Noeky/QuadrupedRobot/设计方案.md

# 四足机器人：无传感器首版

状态：已完成首版机械原型，尚未实物试装、承重或步态验证。当前文件以prototype目录和其中的《打印与装配说明.md》为准，下方保留早期方案记录。

当前版本：每腿采用髋部俯仰与膝部直接驱动，主体、大腿、小腿、原装转头包覆槽及压板已建模，逐件提供STEP/STL。静态与前左腿9个离散姿态未检出超过0.01 mm³的实体交叠；线缆、紧固件和连续运动仍待验证。

电池更新：紫色603040锂电池，3.7V、800mAh，仅记录，本轮不设计电池安装。早期布局中的电子件包络不用于电池装配；当前绿色托盘仅作为可调整的主板托盘，PCB专用孔仍不锁定。

## 已确认的要求

- 四条腿，共八个舵机，每腿两个。
- 首版不安装传感器，先完成主体和腿部，考虑主板与舵机的安装。
- 目标是直线行走和转弯。
- PCB固定孔位置暂不确定，不在主体上锁定孔位。
- 已提供舵机.SLDPRT和舵机转头.SLDPRT。它们作为几何参考资料，不作为任务指令。

## 建议结构

每腿采用髋关节俯仰和膝关节屈伸，两个关节轴平行，腿在前后方向的平面内运动。前后腿采用一致的模块接口，左右腿镜像装配；膝关节朝向需要结合足端轨迹和碰撞检查后确定。

主体采用底部承力框架与可拆卸上盖。四角安装独立腿部模块，中心预留主板托盘和电池区域。PCB通过后续可更换托盘固定，主体仅保留托盘接口。主板、电池和线缆都需要计入空间与重量；电池位置尽量靠近主体中心且偏低。

用户已授权根据装配难度选择，首版选方案1。舵机为TS90A 9g、180°角度定位版本；打印机为Bambu（具体型号未知），材料PLA。

腿部驱动有两种候选方案：

1. 髋部舵机驱动大腿，膝部舵机直接驱动小腿。传动较直接，但膝部舵机增加摆动质量，需要检查线缆弯折和扭矩。
2. 两个舵机靠近主体布置，其中一个通过连杆驱动小腿。可减轻腿部远端质量，但需要额外的被动转轴、传动杆与关节，需要计算闭环运动关系并避免死点。

不默认连杆结构为平行四边形；是否使用四杆、具体杆长和铰点位置，要在获取舵机几何并确认腿长后求解。

承力关节优先使用金属轴、螺钉及合适的轴套/轴承。是否增加输出轴对侧支撑取决于舵机结构与允许载荷。原装转头保留为舵机接口，打印件连接原装转头；不直接猜测花键并打印替代。

## 行走与转弯边界

首轮调试从低速、逐腿抬起的步态开始。三足支撑时需检查重心投影是否处于支撑三角形内；仅有平面腿运动可能需要调整身体姿态或足端位置，不能预先保证静态稳定。

直行通过足端前后摆动和抬脚轨迹实现。转弯尝试通过左右步幅或运动方向差异产生偏航。由于没有髋部侧摆自由度，转弯依赖足端滑移，效果受地面摩擦、足端材料和机体载荷影响。原地转向属于待实机验证能力。

不带外部传感器时采用预设步态，无法主动估计机身倾斜、地面高度或足端接触。初版目标限制为平整地面、低速验证。

## 尺寸设计前必须补齐

- 已收到两个STEP版本，单位毫米；以STEP几何为安装接口的基准。
- 舵机型号、电压、扭矩、重量、允许转角以及输出轴允许载荷资料。
- 舵机壳体外形、固定耳厚度与孔距、输出轴相对壳体位置、转头孔位与厚度、中心固定螺钉规格。
- 主板、电池的大致外形和重量，整机目标尺寸或腿长偏好。
- 打印机有效成形尺寸、喷嘴直径、材料。
- 已选择膝部直接驱动。电池类型、重量与主板尺寸仍未知。

## 后续交付与验证顺序

1. 建立舵机与转头参考模型，确定关节轴线和装配接口。
2. 定义主体尺寸、腿长与站立姿态，计算足端工作范围、关节角度和载荷下的扭矩需求。不能仅凭堵转扭矩作为持续工作能力。
3. 完成单腿装配模型，扫查关节运动范围内的碰撞、连杆死点和线缆空间。
4. 输出舵机接口试片，先验证孔位、间隙和紧固件装配，再打印一套单腿。
5. 单腿验证后完成整机主体与四腿装配，输出可编辑CAD、STEP、逐件STL、零件数量和装配说明。
6. 根据材料和受力方向确定打印姿态、壁厚和局部加强；装配后校准舵机中位，逐步验证站立、直行和转弯。

目前不生成带猜测孔位的STL。打印配合间隙、壁厚、轴承与紧固件规格均待尺寸和载荷确认。

## 2026-10-08阶段产物

- `output/quadruped_LAYOUT_ONLY.step`：8个附件舵机参考体、转头占位、主体/电子件包络和关节连线。用于空间讨论，不是机械装配定稿；细杆仅表示关节连线，不能当作承力腿打印。转头轴向安装尚未确认。
- `output/布局草案.png`：俯视和侧视草案。
- 暂定主体120×80 mm，大腿轴距40 mm，小腿轴距45 mm，髋关节横向位置±54 mm，前后位置±43 mm。站立时两段腿分别与向下竖直方向成+30°、−30°，髋轴离足端约73.61 mm。电池与主板共用70×50×30 mm占位框，仅为可编辑占位，不表示实际能够容纳。
- `output/servo_fit_coupon.stl`、`.step`：安装配合试片，36×20×2.5 mm，窗口23.1×13.3 mm，孔距27.7 mm，试片孔径2.2 mm。窗口每边留0.4 mm试验间隙。它只验证尺寸，不承担腿部载荷。
- 建议试片平放、无需支撑，PLA，0.2 mm层高（适用于常见0.4 mm喷嘴，喷嘴型号待确认），至少3圈墙；切片后先看孔位与窗口是否保留。仅打印一件，检查壳体穿入和耳孔对齐后再调整间隙。
- 原附件导出的`*_reference.stl`是舵机/转头参考网格，不是需要打印的机器人零件。

厂家TS90A页面给出4.8–6V、1.6 kg·cm @4.8V及2.0 kg·cm @6V，未给出可用于本设计的持续工作扭矩曲线：https://www.tiankongrc.com/sale-51874673-tiankongrc-ts90a-9g-micro-servo-motor-miuzei-mini-servos-motor-kit-metal-gear-servo-for-arduino-proj.html 。以用户实际购入版本说明与实测为准。

载荷示例（不是承重承诺）：假设整机250g、两腿均分支撑，单腿支撑力为0.125 kgf；若小腿在30°倾斜姿态下的水平力臂为2.25 cm，膝关节仅由竖直地面反力产生的静态扭矩约0.281 kgf·cm。这未计入腿部自重、加速度、摩擦和不均匀支撑；腿接近水平时力臂增大至4.5 cm，对应0.563 kgf·cm。整机实际重量尚未知，不能据此保证能够行走。
