Noeky/QuadrupedRobot/重新生成说明.md

# 重新生成机械原型

通常只需将prototype目录的STL导入Bambu Studio，或将逐件STEP、装配STEP导入SolidWorks查看和修改。STEP为导入实体，没有原生SolidWorks特征树。

需要修改参数重新生成时，用Python 3.12安装cad_requirements.txt中的依赖到项目的.cad_runtime目录，再运行build_prototype.py。这个环境已配置完成。

```powershell
python -m pip install --target .cad_runtime -r cad_requirements.txt
python build_prototype.py
python render_prototype.py
python check_stl.py
```

修改build_prototype.py开头的P字典可调整主体长宽、关节位置、腿长、膝轴外移、安装孔、口袋间隙等主要参数。parameters.json是生成时的记录，并非输入配置。修改后必须重新检查validations和实体连接情况；过大的尺寸变化可能导致支架断开或干涉，此时脚本的单实体检查或碰撞报告需要进一步修正结构。

render_prototype.py使用CadQuery依赖中的VTK生成预览；Windows需要正常的OpenGL驱动。预览生成失败不代表CAD实体失败。

原始舵机.STEP和舵机转头.STEP必须保留在脚本同级目录。输出包含原装舵机/转头参考体，不应打印这些参考体。
