Noeky/QuadrupedRobot/archive/README.md

# 历史布局

`layout/`保留首轮空间布局、参数与示意图，用于查看设计过程。布局中的细杆仅表示关节连线，转头姿态和电子件空间为早期占位，不能直接用于制造。

当前机械原型位于[`cad/prototype/`](../cad/prototype/)，使用前阅读[打印与装配说明](../docs/打印与装配说明.md)。
