Noeky/QuadrupedRobot/docs/images/零件尺寸参考.png

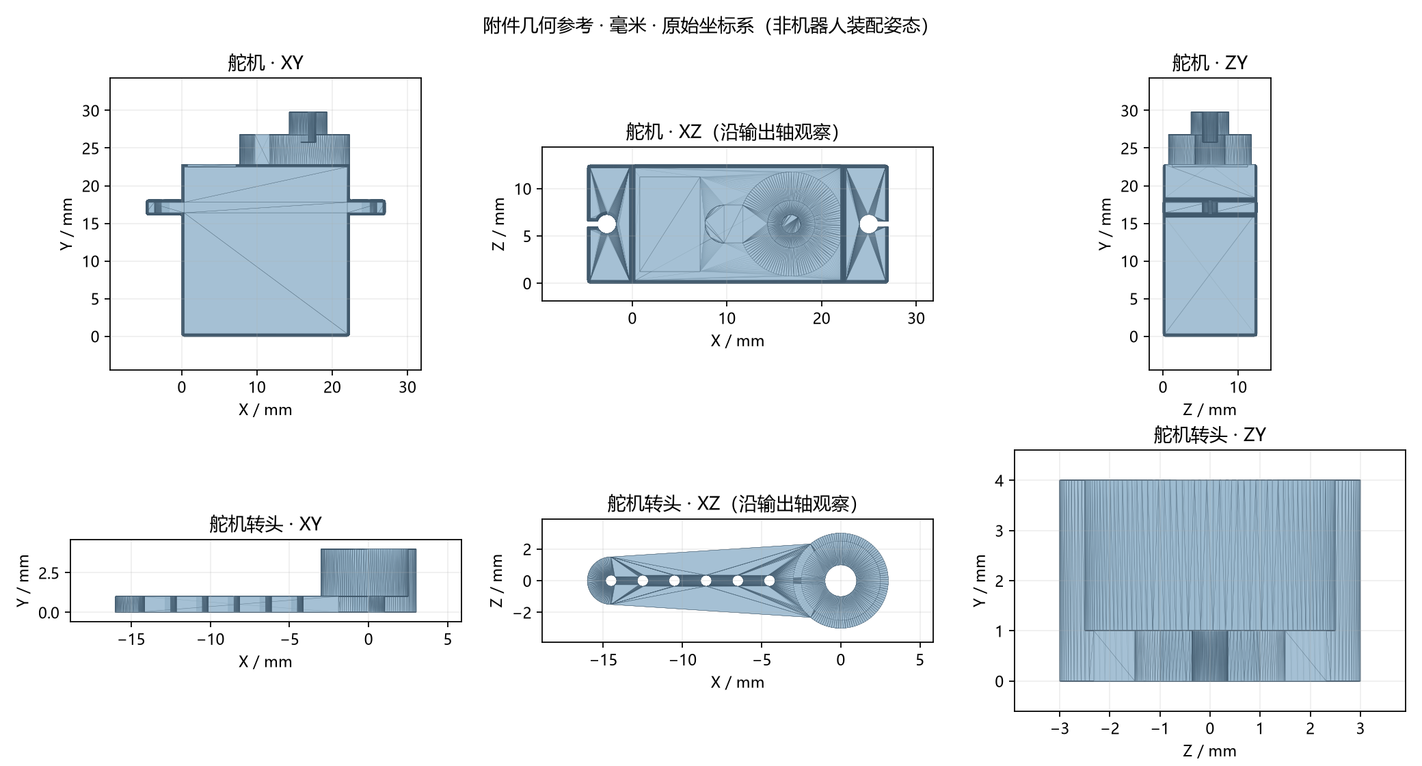
docs/images/零件尺寸参考.png
