Noeky/QuadrupedRobot/prototype/转头连接说明.png

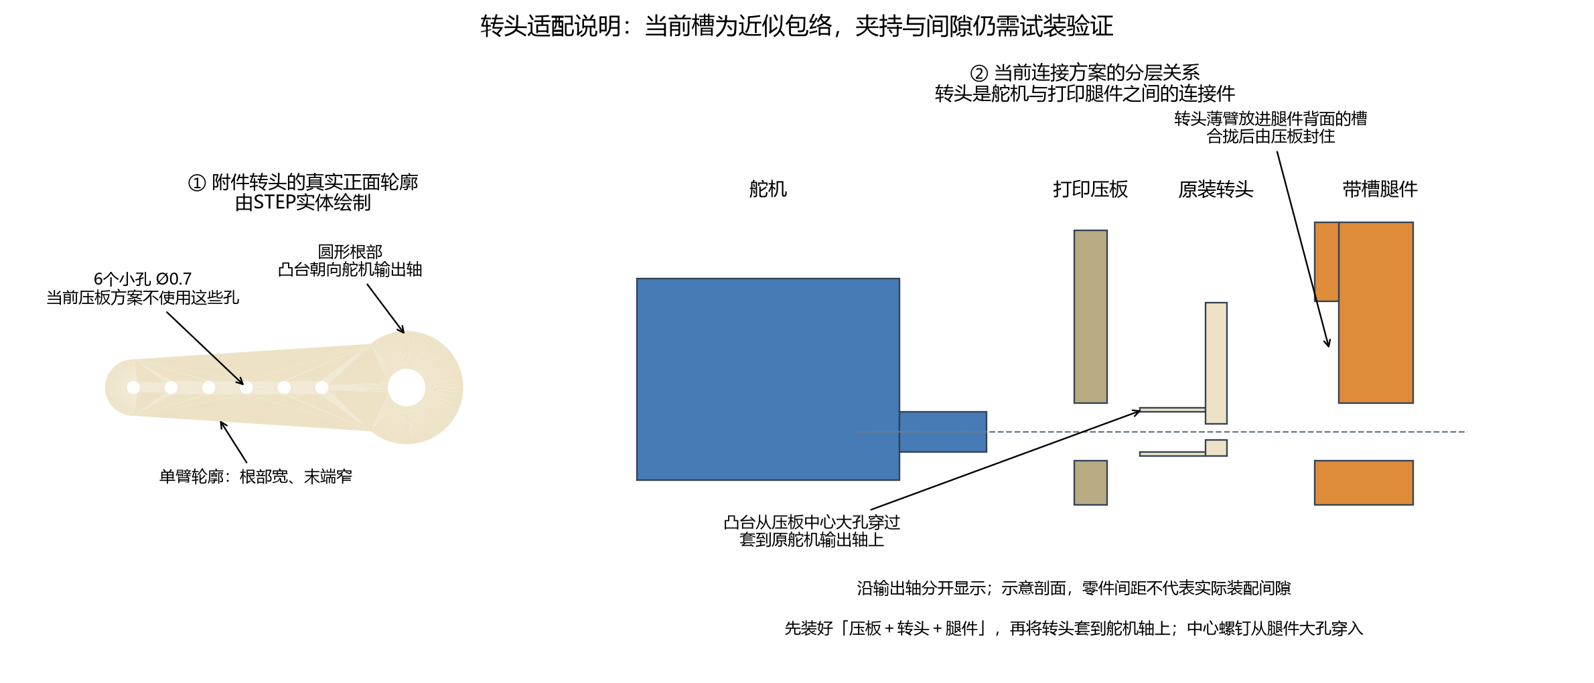
prototype/转头连接说明.png
