Noeky/QuadrupedRobot/cad/prototype/step/quadruped_prototype_assembly.step

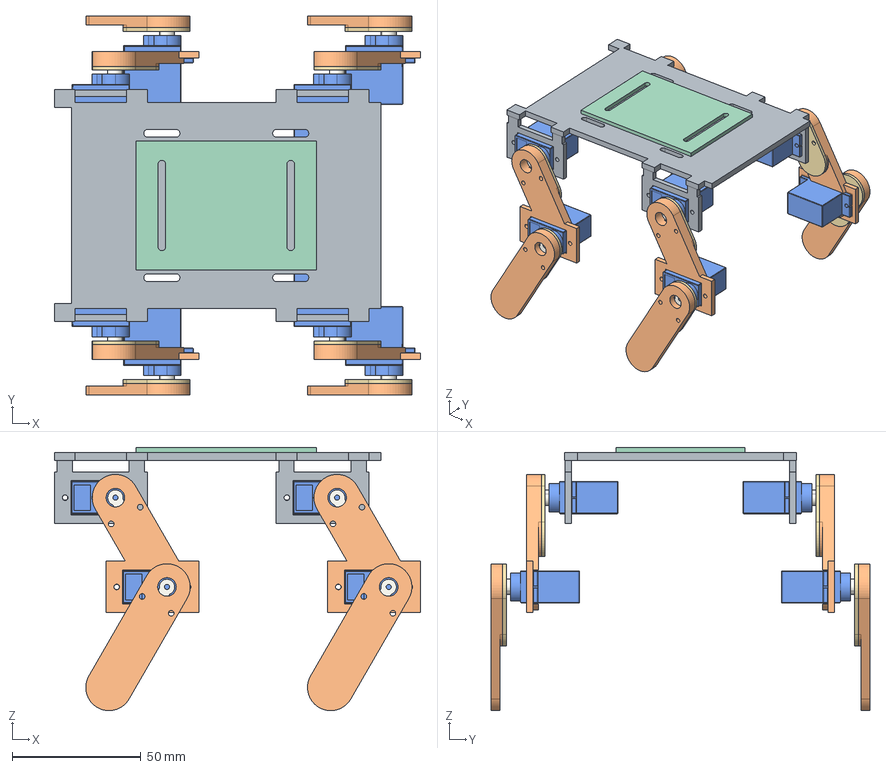
[picture p4: CAD file, 2026-10-15]
cad/prototype/step/quadruped_prototype_assembly.step
142.0 x 147.0 x 102.1 mm
tray
rear_right_hip_servo
rear_right_hip_horn
rear_right_thigh
rear_right_hip_clamp
rear_right_knee_servo
rear_right_knee_horn
rear_right_shin
rear_right_knee_clamp
rear_left_hip_servo
rear_left_hip_horn
rear_left_thigh
rear_left_hip_clamp
rear_left_knee_servo
rear_left_knee_horn
rear_left_shin
rear_left_knee_clamp
front_right_hip_servo
front_right_hip_horn
front_right_thigh
front_right_hip_clamp
front_right_knee_servo
front_right_knee_horn
front_right_shin
front_right_knee_clamp
front_left_hip_servo
front_left_hip_horn
front_left_thigh
front_left_hip_clamp
front_left_knee_servo
front_left_knee_horn
front_left_shin
front_left_knee_clamp
