Noeky/QuadrupedRobot/cad/fit_coupon/servo_fit_coupon.step

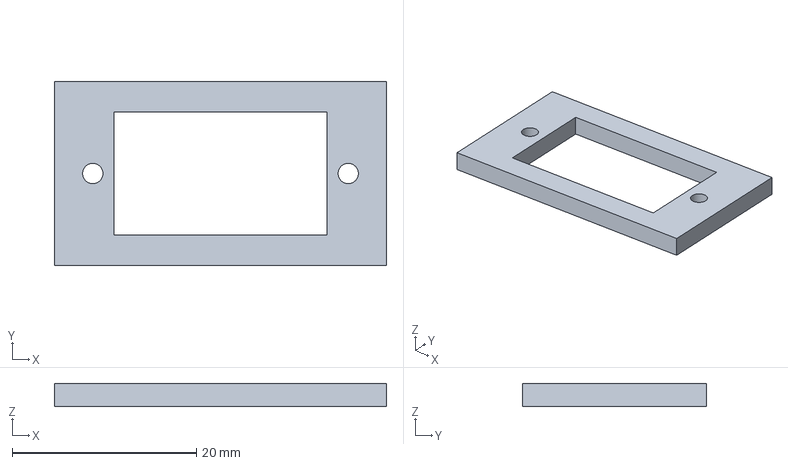
[picture p5: CAD file, 2026-10-15]
cad/fit_coupon/servo_fit_coupon.step
36.0 x 20.0 x 2.50 mm
