Noeky/QuadrupedRobot/cad/prototype/step/body.step

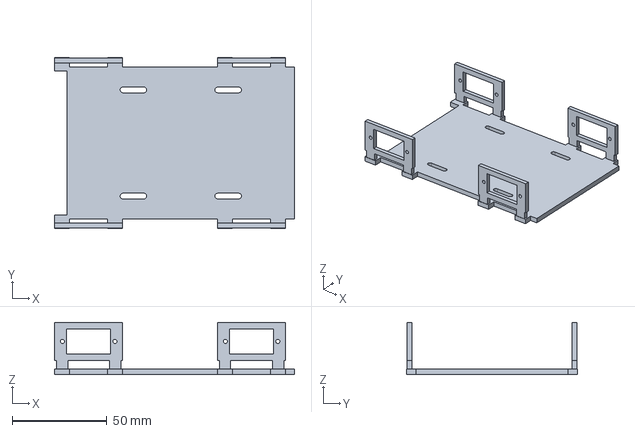
[picture p6: CAD file, 2026-10-15]
cad/prototype/step/body.step
126.7 x 90.0 x 27.5 mm
