Noeky/QuadrupedRobot/hardware/reference/舵机_reference.stl

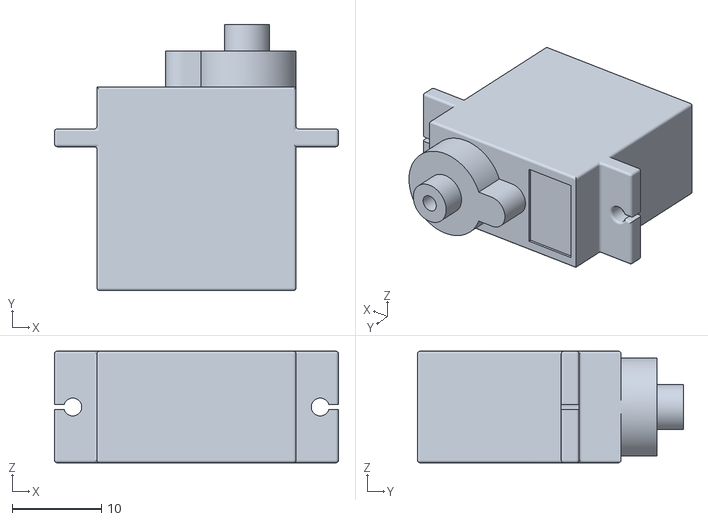
[picture p7: CAD file, 2026-10-15]
hardware/reference/舵机_reference.stl
31.8 x 29.8 x 12.5
