Noeky/QuadrupedRobot/output/quadruped_LAYOUT_ONLY.step

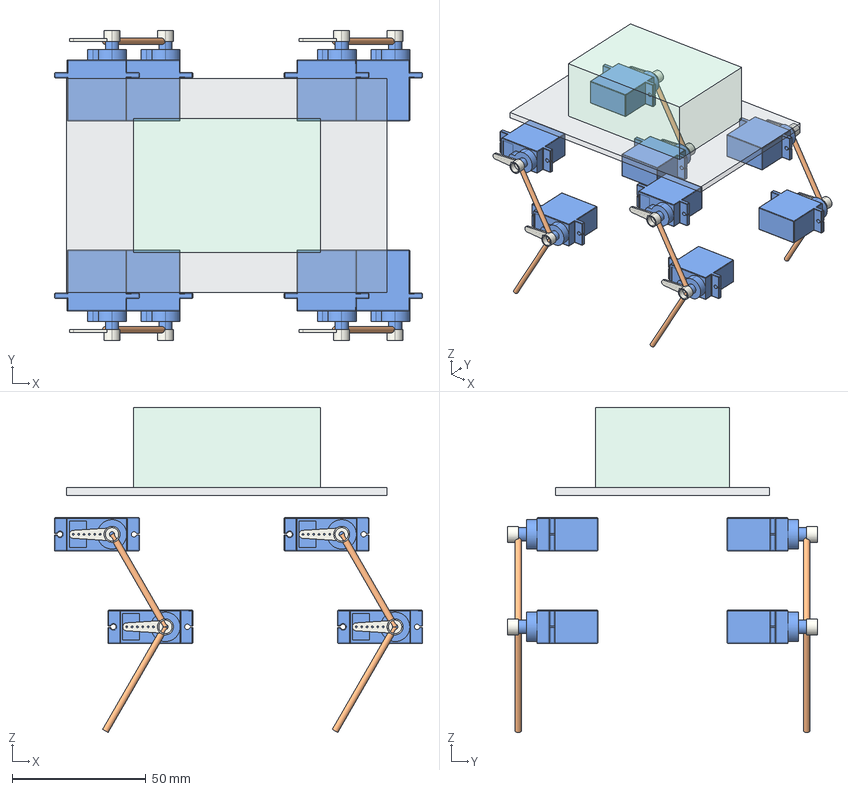
[picture p8: CAD file, 2026-10-15]
output/quadruped_LAYOUT_ONLY.step
137.8 x 116.0 x 121.7 mm
deck_envelope
unknown_electronics_envelope
front_left_hip_servo
front_left_hip_horn_envelope
front_left_knee_servo
front_left_knee_horn_envelope
front_left_thigh_axis_placeholder
front_left_shin_axis_placeholder
front_right_hip_servo
front_right_hip_horn_envelope
front_right_knee_servo
front_right_knee_horn_envelope
front_right_thigh_axis_placeholder
front_right_shin_axis_placeholder
rear_left_hip_servo
rear_left_hip_horn_envelope
rear_left_knee_servo
rear_left_knee_horn_envelope
rear_left_thigh_axis_placeholder
rear_left_shin_axis_placeholder
rear_right_hip_servo
rear_right_hip_horn_envelope
rear_right_knee_servo
rear_right_knee_horn_envelope
rear_right_thigh_axis_placeholder
rear_right_shin_axis_placeholder
