Noeky/QuadrupedRobot/cad/prototype/step/shin.step

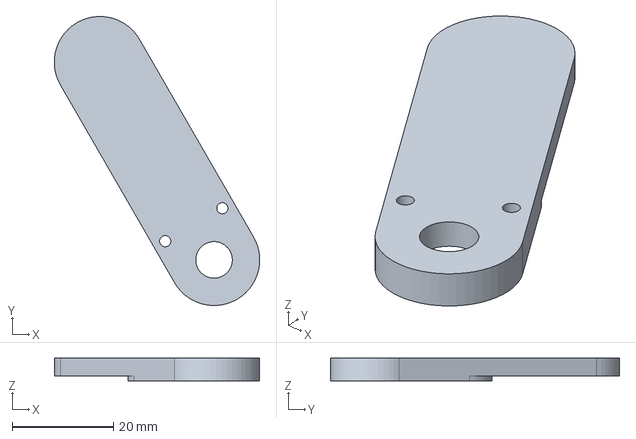
[picture p9: CAD file, 2026-10-15]
cad/prototype/step/shin.step
40.5 x 57.0 x 4.50 mm
