Noeky/QuadrupedRobot/hardware/reference/舵机转头_reference.stl

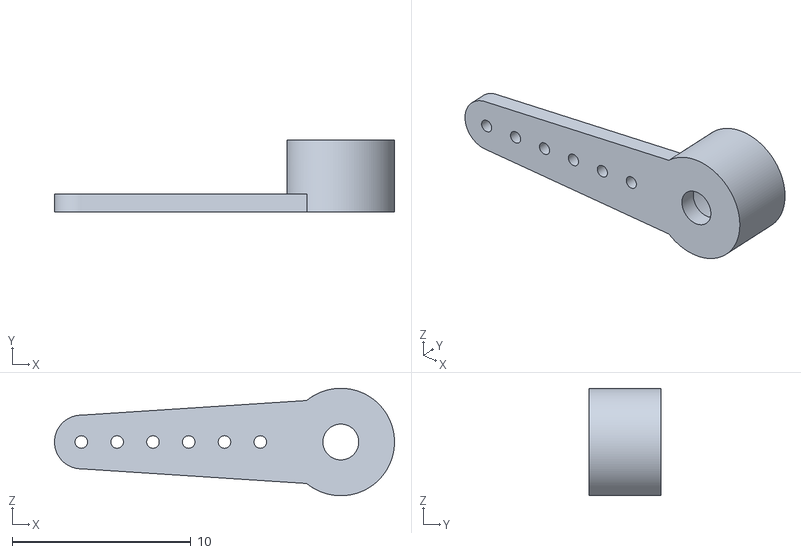
[picture p10: CAD file, 2026-10-15]
hardware/reference/舵机转头_reference.stl
19.0 x 4.00 x 6.00
