Noeky/QuadrupedRobot/cad/prototype/step/universal_tray.step

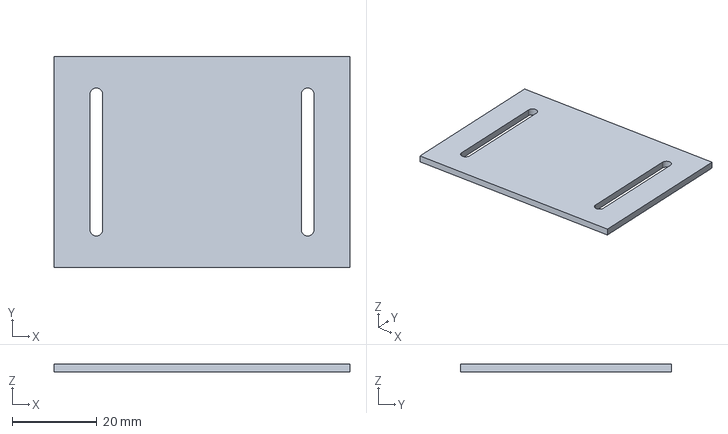
[picture p11: CAD file, 2026-10-15]
cad/prototype/step/universal_tray.step
70.0 x 50.0 x 2.00 mm
