Noeky/QuadrupedRobot/cad/prototype/step/hip_horn_clamp.step

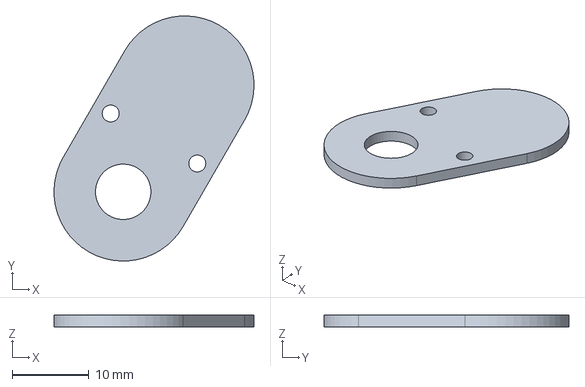
[picture p12: CAD file, 2026-10-15]
cad/prototype/step/hip_horn_clamp.step
26.0 x 31.8 x 1.50 mm
