Noeky/QuadrupedRobot/cad/prototype/step/thigh_right.step

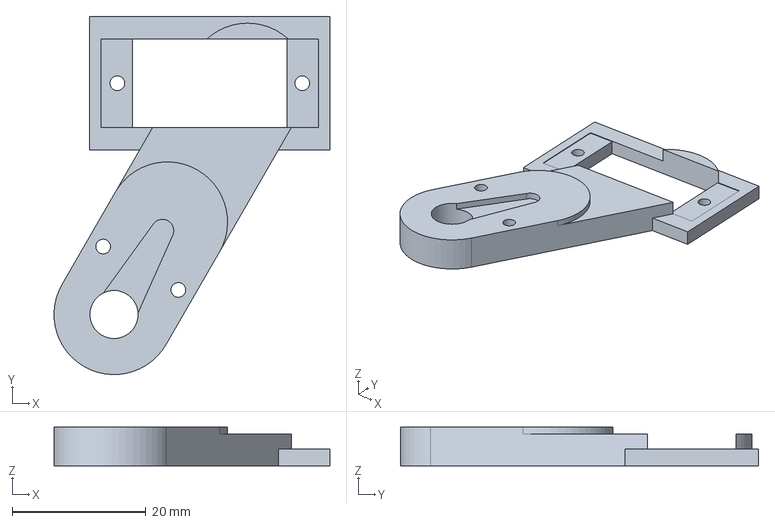
[picture p13: CAD file, 2026-10-15]
cad/prototype/step/thigh_right.step
41.3 x 53.6 x 5.80 mm
