Noeky/QuadrupedRobot/(list of files, cad)

Other CAD files:
舵机.STEP
output/servo_fit_coupon.step
舵机转头.STEP
cad/prototype/step/thigh_left.step
cad/prototype/step/knee_horn_clamp.step
archive/layout/quadruped_LAYOUT_ONLY.step
cad/fit_coupon/servo_fit_coupon.stl
cad/prototype/stl/body.stl
cad/prototype/stl/hip_horn_clamp.stl
cad/prototype/stl/knee_horn_clamp.stl
cad/prototype/stl/shin.stl
cad/prototype/stl/thigh_left.stl
cad/prototype/stl/universal_tray.stl
prototype/body.step
prototype/hip_horn_clamp.step
prototype/knee_horn_clamp.step
prototype/quadruped_prototype_assembly.step
prototype/shin.step
prototype/thigh_left.step
prototype/thigh_right.step
prototype/thigh_right.stl
prototype/universal_tray.step
