Noeky/QuadrupedRobot/docs/打印与装配说明.md

# 无传感器四足机器人：PLA机械原型

当前机械原型位于`cad/prototype/`：`step/`保存CAD，`stl/`保存打印文件；本文位于`docs/`。已用附件STEP确定安装几何，尚未经实物试装、载荷和步态测试；不是已验证的整机生产定稿。`quadruped_prototype_assembly.step`包含附件舵机与转头，紧固件及线缆未建模。`archive/layout/`目录中的布局线段是早期布局参考，以`cad/prototype/`中的机械原型为后续修改基准。

## 确定与暂定参数

- 用户硬件：八个TS90A 9g、180°角度定位舵机；Bambu打印机；PLA。
- 电池仅记录：紫色603040，3.7V、800mAh。本轮不设计或装配电池部分；603040不作为实测外形尺寸使用。
- 主体主平台120×80×3 mm，四处安装耳支架与连接肋一体打印，总打印包络约126.65×90×27.5 mm。
- 当前站姿的完整装配包络约142×147×102.11 mm，包含腿的圆弧足端；这不是主体平台尺寸。
- 髋轴前后位置±43 mm、左右位置±54 mm；大腿轴距40 mm，小腿轴距45 mm。这两个轴距是平行关节轴在XZ平面中的垂直距离。
- 膝舵机输出轴比髋轴向外偏15 mm，为大腿支架和小腿留出轴向空间。四腿均在平行的前后运动平面内运动，没有侧摆关节。
- 主板通用托盘70×50×2 mm，无PCB专用孔；主板实际尺寸未知，可以调整或暂不打印。托盘长槽与主体长槽用于绑带/扎带固定，不用于电池固定。
- 附件舵机壳体主要矩形段22.3×12.5×22.8 mm；包含安装耳及输出轴的总包络31.8×12.5×29.8 mm。源文件坐标X是壳体长向，Y是输出轴方向，Z是壳体厚向。
- 安装耳孔径2 mm、孔距27.7 mm；耳部轴向范围Y=16.1～18.1 mm。打印安装窗口23.1×13.3 mm，安装孔2.2 mm。先以试片确认真实零件与导出模型一致。
- 转头包络19×6×4 mm；臂上6个孔径0.7 mm的小孔，距轴心4.5、6.5、8.5、10.5、12.5、14.5 mm。原型采用原装转头与包覆槽/压板连接，不打印花键，不依赖这排小孔承力。

## 文件及数量

|文件|数量|用途|
|---|---:|---|
|body.stl / .step|1|主体平台与四个髋舵机安装框|
|thigh_left.stl / .step|2|左侧大腿与膝舵机安装框|
|thigh_right.stl / .step|2|右侧镜像大腿|
|shin.stl / .step|4|小腿；右侧需翻面安装以使包覆槽朝向原装转头|
|hip_horn_clamp.stl / .step|4|髋转头压板|
|knee_horn_clamp.stl / .step|4|膝转头压板|
|universal_tray.stl / .step|0～1|暂定主板托盘|
|quadruped_prototype_assembly.step|1|装配检查用，不作为整体打印模型|
|validation.json|1|实体、打印尺寸、静态交叠和离散姿态检查结果|

两种压板在本版几何上可通过绕长轴翻转互换，但分别命名以便装配识别。压板的螺钉孔均为通孔，需要螺母与垫片。

## 建议先打印的件

先打印`cad/fit_coupon/servo_fit_coupon.stl`一件，检查舵机壳体穿过窗口、耳孔对齐。然后仅打印左大腿、小腿、两块压板各一件，先验证一条腿。确认转头口袋、孔位、螺钉和膝舵机装配，再打印主体与其余三腿。

所有独立STL均已转到建议床面方向并平移至非负坐标，切片导入比例必须为100%、单位毫米。

- 常见0.4 mm喷嘴时，首轮采用0.2 mm层高、至少4圈墙、5层顶底、30%～40%填充；压板和孔周围使用局部100%填充。具体喷嘴和PLA厂家参数以打印机配置为准。
- 主体平台顶面朝床，舵机安装框朝上。窗口桥接与局部悬空处在切片中检查，必要时使用仅从打印板生成的支撑；避免支撑挤满小孔。
- 大腿与小腿的宽面平放。包覆槽与膝安装耳的避让台阶有小跨度悬空，在切片预览逐层检查；根据桥接效果决定局部支撑。
- 左右大腿是不同文件，不要将左侧件重复打印四件代替镜像件。
- 足端目前为小腿末端的圆弧PLA轮廓，可在实物调试时加薄橡胶防滑垫。转弯需要适量滑移，足垫摩擦要在直行与转弯测试中调整。

## 紧固件与装配顺序

需要原装舵机转头8件及其中心螺钉8枚（型号按随舵机配件，不猜测螺纹规格）。每个转头压板使用2套螺钉/螺母，共16套；每个舵机安装耳2套，共16套。

试装起点：压板可先用M2×10通孔螺钉、M2螺母和小垫片；舵机安装耳可先用M2×8。原模型耳孔是2 mm，实物可能更紧，应先确认随舵机螺钉或M2能穿入；不在未测量情况下强拧。螺钉头、螺母、垫片的实际外径及高度尚未加入干涉模型，这些长度是试装选项，需以试装确认，必要时改用合适的M1.6配件并修改打印孔径。

1. 在断开机械负载时通过控制板将舵机置中，确认实际可控角度，再断电装转头。未校准前不直接发送极限位置。
2. 髋舵机从主体安装窗口装入，原装耳部贴合框架，使用两个安装孔固定。
3. 先在舵机之外将髋转头薄臂放入大腿包覆槽，压板置于转头背面，使圆筒凸台穿过压板中心大孔；用两套通孔紧固件将这三件预装在一起。再把转头套到舵机输出轴上，从腿件中央大孔装入原装中心螺钉。不能在转头已锁到舵机后再假定闭合压板可以从侧面插入。
4. 将膝舵机从大腿末端窗口装入，并固定两个耳孔。膝舵机输出端朝外，较髋输出端外移15 mm。
5. 用相同方式安装膝转头、小腿和膝压板。原装转头臂与腿长向对齐。
6. 右侧按装配STEP镜像安装；小腿与压板绕其长向翻面，使槽口朝向转头。不要只依据STL在打印床上的朝向判断装配朝向。
7. 手动低负载检查转头槽是否有松动、是否挤压舵机壳体，以及螺钉头/螺母是否碰到壳体。当前槽是圆根部与渐窄单臂的近似包络，侧向预留约0.2 mm、轴向约0.1 mm。压板与槽边接触后仍可能留下这0.1 mm间隙，因此它目前主要限制转头脱出，不能保证形成预紧夹持。单腿试片需要用薄垫片验证接触，再调整槽深/压板接触面消除松动；不以加大夹紧力压坏原装塑料转头。详见[转头连接说明](images/转头连接说明.png)。
8. 单腿悬空从中位小角度往返，再做受支撑的承重试验。通过后复制四腿，固定主板与线缆。线缆需预留松弛回路并避开关节与足端。

## 验证边界与下一步

`reports/validation.json`记录本次生成时的结果。静态检查采用精确实体布尔交集，忽略小于等于0.01 mm³的交叠及零体积接触。运动检查只对前左腿的9个离散姿态进行，其他腿保持站姿，不是连续扫动，也没有验证实际步态或舵机控制映射。

本次结果：静态及9个姿态均未检出超过阈值的实体交叠。所有逐件STL及安装试片在1e-5 mm坐标焊接后均为闭合网格，无非流形边、反向不一致边和退化三角形，详见`reports/stl_validation.json`。上述检查不包括紧固件与线缆，也不替代切片预览或实物测试。

待验证项目：真实零件打印配合、转头夹持抗滑、关节螺钉干涉、线缆空间、舵机输出轴侧向载荷、主板尺寸、整机实际重量、连续工作温升、站立与行走稳定性。原型未增加输出轴对侧轴承支撑，单腿承重测试将决定是否增加支撑或缩短腿长。

两自由度腿的直行和差动转弯需由步态与地面试验确认。前后腿同方向屈膝只是本版几何起点。无传感器版本不能主动感知地面、接触或机身倾斜。不能仅凭CAD无碰撞保证能够行走。

3.7V电池的信息仅记录。厂家TS90A页面标示4.8～6V，后续电气设计需确认现有PCB是否能提供所需电压与电流；本轮不据此增加电池装配或供电电路。

参数来源：https://www.tiankongrc.com/sale-51874673-tiankongrc-ts90a-9g-micro-servo-motor-miuzei-mini-servos-motor-kit-metal-gear-servo-for-arduino-proj.html 。扭矩、电压与真实购入批次仍应以原配说明和实测核实。

可编辑源文件为`scripts/build_prototype.py`；`reports/parameters.json`记录参数，当前修改应在脚本中完成后重新生成。STEP可在SolidWorks作为导入实体打开，不包含原生SolidWorks特征树。

本文中未注明目录的STEP和STL文件名，分别位于仓库的`cad/prototype/step/`和`cad/prototype/stl/`。参数和检查报告位于`docs/reports/`，预览位于`docs/images/`。
